ChewbaccaBox/Cinematronics-Exorcisor/Images/5004a.jpg

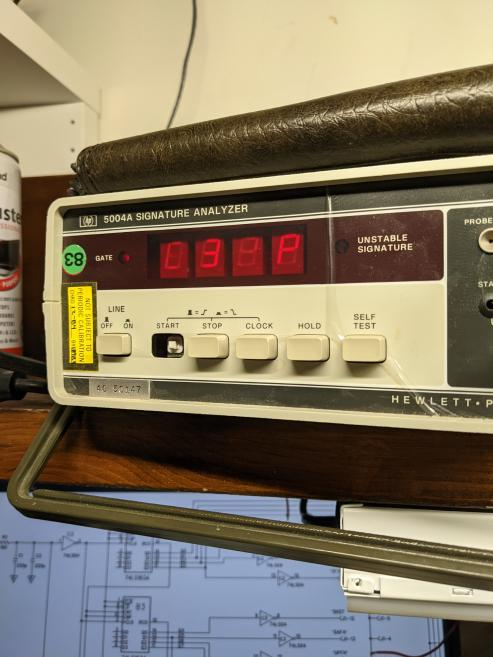
Images/5004a.jpg
