ChewbaccaBox/Cinematronics-Exorcisor/Kicad/exorcisortry2.sch

## KiCad design Kicad/exorcisortry2.sch (2022-06-01)

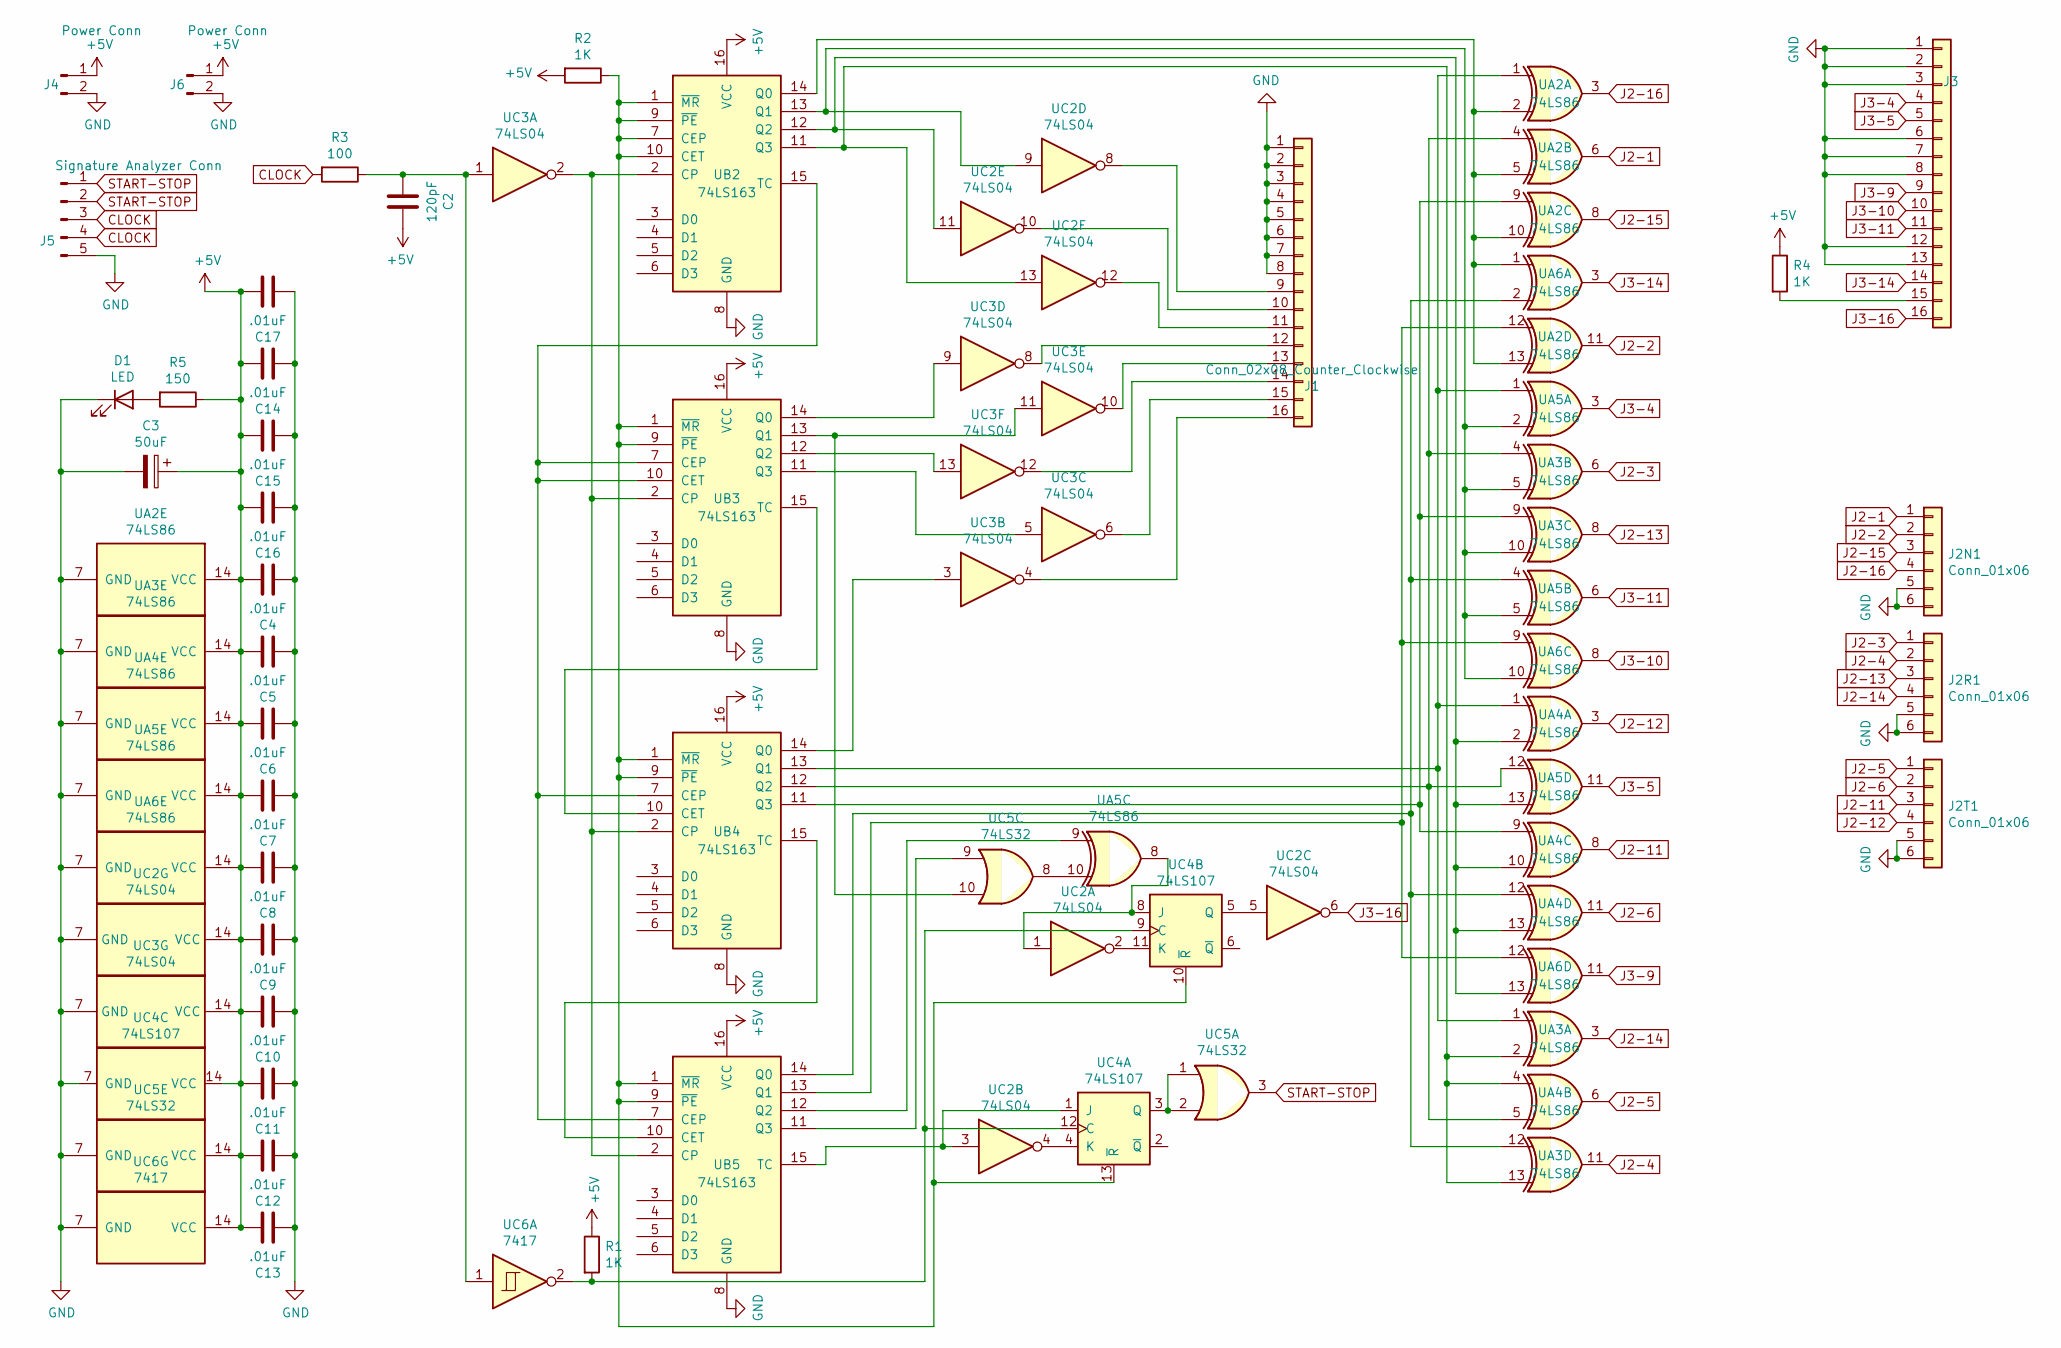
[picture p4: schematic exorcisortry2.sch]

Parts:
C2: 120pF; C_1206_3216Metric_Pad1.33x1.80mm_HandSolder
C3: 50uF; CP_Radial_D6.3mm_P2.50mm
C4, C5, C6, C7, C8, C9, C10, C11, C12, C13, C14, C15, C16, C17: .01uF; C_1206_3216Metric_Pad1.33x1.80mm_HandSolder
D1: LED; LED_D5.0mm_FlatTop
J1, J3: Conn_02x08_Counter_Clockwise; PinHeader_2x08_P2.54mm_Vertical
J2N1, J2R1, J2T1: Conn_01x06; PinHeader_2x03_P2.54mm_Vertical
J4, J6: Power Conn; PinHeader_1x02_P2.54mm_Vertical
J5: Signature Analyzer Conn; PinHeader_1x05_P2.54mm_Vertical
R1, R2, R4: 1K; C_1206_3216Metric_Pad1.33x1.80mm_HandSolder
R3: 100; C_1206_3216Metric_Pad1.33x1.80mm_HandSolder
R5: 150; C_1206_3216Metric_Pad1.33x1.80mm_HandSolder
UA2, UA3, UA4, UA5, UA6: 74LS86; DIP-14_W7.62mm_LongPads
UB2, UB3, UB4, UB5: 74LS163; DIP-16_W7.62mm_LongPads
UC2, UC3: 74LS04; DIP-14_W7.62mm_LongPads
UC4: 74LS107; DIP-14_W7.62mm_LongPads
UC5: 74LS32; DIP-14_W7.62mm_LongPads
UC6: 7417; DIP-14_W7.62mm_LongPads

Connections:
+5V: C2.1, C3.1, C4.1, C5.1, C6.1, C7.1, C8.1, C9.1, C10.1, C11.1, C12.1, C13.1, C14.1, C15.1, C16.1, C17.1, J4.1, J6.1, R1.1, R2.2, R4.1, R5.1, UA2.14 (VCC), UA3.14 (VCC), UA4.14 (VCC), UA5.14 (VCC), UA6.14 (VCC), UB2.16 (VCC), UB3.16 (VCC), UB4.16 (VCC), UB5.16 (VCC), UC2.14 (VCC), UC3.14 (VCC), UC4.14 (VCC), UC5.14 (VCC), UC6.14 (VCC)
CLOCK: J5.3, J5.4, R3.2
GND: C3.2, C4.2, C5.2, C6.2, C7.2, C8.2, C9.2, C10.2, C11.2, C12.2, C13.2, C14.2, C15.2, C16.2, C17.2, D1.1 (K), J1.1, J1.2, J1.3, J1.4, J1.5, J1.6, J1.7, J1.8, J2N1.5, J2N1.6, J2R1.5, J2R1.6, J2T1.5, J2T1.6, J3.1, J3.2, J3.3, J3.6, J3.7, J3.8, J3.12, J3.13, J4.2, J5.5, J6.2, UA2.7 (GND), UA3.7 (GND), UA4.7 (GND), UA5.7 (GND), UA6.7 (GND), UB2.8 (GND), UB3.8 (GND), UB4.8 (GND), UB5.8 (GND), UC2.7 (GND), UC3.7 (GND), UC4.7 (GND), UC5.7 (GND), UC6.7 (GND)
J2-1: J2N1.1, UA2.6
J2-2: J2N1.2, UA2.11
J2-3: J2R1.1, UA3.6
J2-4: J2R1.2, UA3.11
J2-5: J2T1.1, UA4.6
J2-6: J2T1.2, UA4.11
J2-11: J2T1.3, UA4.8
J2-12: J2T1.4, UA4.3
J2-13: J2R1.3, UA3.8
J2-14: J2R1.4, UA3.3
J2-15: J2N1.3, UA2.8
J2-16: J2N1.4, UA2.3
J3-4: J3.4, UA5.3
J3-5: J3.5, UA5.11
J3-9: J3.9, UA6.11
J3-10: J3.10, UA6.8
J3-11: J3.11, UA5.6
J3-14: J3.14, UA6.3
J3-16: J3.16, UC2.6
unnamed: C2.2, R3.1, UC3.1, UC6.1
unnamed: D1.2 (A), R5.2
unnamed: J1.9, UC2.8
unnamed: J1.10, UC2.10
unnamed: J1.11, UC2.12
unnamed: J1.12, UC3.8
unnamed: J1.13, UC3.10
unnamed: J1.14, UC3.12
unnamed: J1.15, UC3.6
unnamed: J1.16, UC3.4
unnamed: J3.15, R4.2
unnamed: R1.2, UC4.9 (C), UC4.12 (C), UC6.2
unnamed: R2.1, UB2.1 (~MR), UB2.7 (CEP), UB2.9 (~PE), UB2.10 (CET), UB3.1 (~MR), UB3.9 (~PE), UB4.1 (~MR), UB4.9 (~PE), UB5.1 (~MR), UB5.9 (~PE), UC4.10 (~R), UC4.13 (~R)
unnamed: UA2.1, UA3.1, UA4.1, UA5.1, UB4.13 (Q1)
unnamed: UA2.4, UA3.4, UA4.5, UA5.12, UB4.12 (Q2)
unnamed: UA2.9, UA3.9, UA4.9, UB4.11 (Q3)
unnamed: UA2.2, UA2.5, UA2.10, UA2.13, UA6.1, UB2.14 (Q0)
unnamed: UA2.12, UA6.9, UA6.12, UB5.13 (Q1)
unnamed: UA3.5, UA3.10, UA5.2, UA5.5, UA6.10, UB2.13 (Q1), UC2.9
unnamed: UA3.12, UA4.12, UA5.4, UA6.2, UB5.14 (Q0)
unnamed: UA3.2, UA3.13, UA4.4, UB2.11 (Q3), UC2.13
unnamed: UA4.2, UA4.10, UA4.13, UA5.13, UA6.13, UB2.12 (Q2), UC2.11
unnamed: UA5.8, UC2.1, UC4.8 (J)
unnamed: UA5.9, UB5.12 (Q2)
unnamed: UA5.10, UC5.8
unnamed: UB2.2 (CP), UB3.2 (CP), UB4.2 (CP), UB5.2 (CP), UC3.2
unnamed: UB2.15 (TC), UB3.7 (CEP), UB3.10 (CET), UB4.7 (CEP), UB5.7 (CEP)
unnamed: UB3.11 (Q3), UC3.5
unnamed: UB3.12 (Q2), UC3.13
unnamed: UB3.13 (Q1), UC3.11, UC5.10
unnamed: UB3.14 (Q0), UC3.9
unnamed: UB3.15 (TC), UB4.10 (CET)
unnamed: UB4.14 (Q0), UC3.3
unnamed: UB4.15 (TC), UB5.10 (CET)
unnamed: UB5.11 (Q3), UC5.9
unnamed: UB5.15 (TC), UC2.3, UC4.1 (J)
unnamed: UC2.2, UC4.11 (K)
unnamed: UC2.4, UC4.4 (K)
unnamed: UC2.5, UC4.5 (Q)
unnamed: UC4.3 (Q), UC5.1, UC5.2
START-STOP: J5.1, J5.2, UC5.3
