ChewbaccaBox/Cinematronics-Exorcisor/Images/setup.jpg

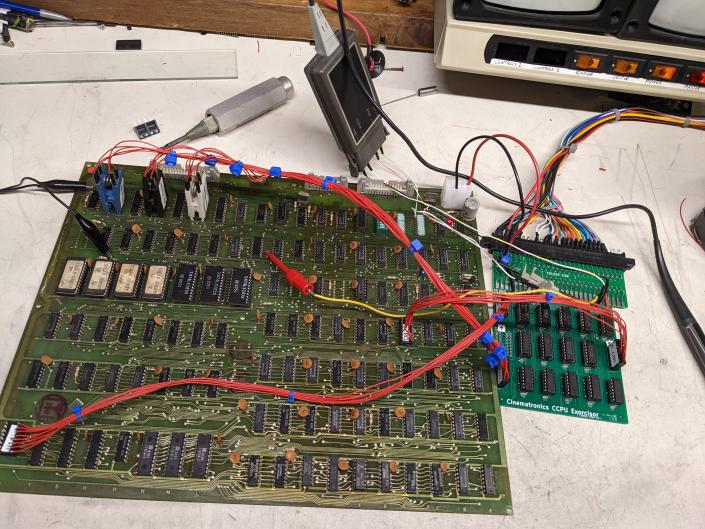
Images/setup.jpg
